MonkeyClicker/VMax-Smart-Gauge/releases/README.md

# Releases

Release notes, manifests, and supporting release metadata belong here.

Compiled OTA firmware binaries should normally be attached to GitHub Releases rather than committed repeatedly to the repository.
