MonkeyClicker/VMax-Smart-Gauge/hardware/datasheets/README.md

# Datasheets

Store links, notes, and redistributable component documentation here.

Primary components:
- [AliExpress male NMEA 2000 pigtail](AliExpress-NMEA2000-Panel-Male.md) — current panel candidate; seller cutout 15.5-16 mm
- [USB-C panel extension, FPC-10cm](USB-C-Panel-Extension.md) — ordered; mounting dimensions and bench verification pending
- [Hat Labs male NMEA 2000 panel pigtail connector](Hat-Labs-NMEA2000-Panel-Male.md) — selected enclosure connector; [CAD specification data](Hat-Labs-NMEA2000-Panel-Male.json)
- Waveshare ESP32-S3-Touch-LCD-5
- ESP32-S3-WROOM-1-N16R8
- TJA1051 CAN transceiver

Do not commit copyrighted vendor documents unless redistribution is permitted; links and engineering notes are preferred.

See the [bill of materials](../BOM.md) for component selections and procurement status.

Purchased component: [Yamaha engine-to-NMEA 2000 interface cable](Yamaha-Engine-Interface-Purchased.md) — Amazon ASIN B0BRM64RSX; user-confirmed purchase.
