MonkeyClicker/VMax-Smart-Gauge/hardware/schematics/README.md

# Schematics

Electrical schematics and protection/interface designs belong here.

The initial prototype uses the Waveshare onboard TJA1051 CAN transceiver. A later permanent-installation design may add galvanic isolation and marine transient protection.
