MonkeyClicker/VMax-Smart-Gauge/enclosure/CAD/README.md

# CAD

Editable enclosure CAD source files belong here.

The design should preserve access to internal USB recovery while keeping normal external penetrations sealed.

Current source: [vmax_dash.scad](vmax_dash.scad). See the [build guide](../README.md) before exporting.
