MonkeyClicker/VMax-Smart-Gauge/enclosure/drawings/README.md

# Drawings

Dimensioned drawings, mounting templates, gasket drawings, and assembly diagrams belong here.

Current files: [preview](preview.png), [1:1 dash template](dash-template.svg), and [mesh checks](mesh-checks.json). The template is provisional; verify the printed case before cutting.
