MonkeyClicker/VMax-Smart-Gauge/media/photos/README.md

# Photos

Add project photos here. Use descriptive filenames and document what each photo shows in the relevant wiring, hardware, or testing guide.
