MonkeyClicker/VMax-Smart-Gauge/nmea/sample-data/README.md

# Sample Data

Small sanitized NMEA 2000 datasets used for parser development and regression testing belong here.

Prefer datasets that cover:
- PGN 127488 engine rapid update
- PGN 127489 engine dynamic
- PGN 127505 fluid level
- PGN 129025 position
- PGN 129026 COG/SOG
- PGN 129029 GNSS
- unavailable-value cases
- stale/disconnected cases
