MonkeyClicker/VMax-Smart-Gauge/media/graphics/vmax-dash-mounted-concept-v1-prompt.txt

Generated using the built-in image generation tool.
Concept visualization; not a dimensional CAD rendering.

Use case: product-mockup. Create a photorealistic premium concept graphic of the V MAX Smart Gauge flush-mounted in a modern performance fishing boat dashboard. Input image is a reference for the actual screen layout and landscape 5-inch 800x480 display, not an image to reproduce as a workbench photograph. Show a tight three-quarter front product view, gauge dominant, with enough surrounding charcoal marine dash, partial steering wheel at lower left and softly blurred water beyond helm to establish installation. Custom cool bezel: satin graphite black sculpted rounded rectangular frame with crisp faceted chamfers, restrained layered shoulders, a narrow metallic electric-blue inlaid perimeter accent (not glowing LED), small tasteful machined corner details, concealed mounting. Screen opening 5:3 landscape, bezel approximately 197mm wide by 162mm tall so substantial upper/lower borders, only a few mm proud of dash, all housing concealed behind panel. Small engraved 'V MAX' centered in lower bezel. Realistic manufacturable industrial design, premium marine accessory, not sci-fi. Screen closely follows reference: navy background, cyan RPM arc on left reading 4465 ENGINE RPM, right six tiles GPS SPEED 42.0 mph, TRIM 38%, FUEL FLOW 14.3 gph, ENGINE TEMP 150 F, OIL PRESSURE 62 psi, COURSE 84 deg; bottom data and five navigation tabs ENGINE PERFORMANCE TRIP DIAGNOSTICS SETTINGS. Keep screen readable and properly in perspective. Soft natural daylight, subtle glass reflections, crisp realistic materials, shallow depth of field but entire bezel sharp. Landscape hero image. No infographic labels, no explanatory text, no watermark, no exposed wires, no bracket, no giant knobs.
