MonkeyClicker/VMax-Smart-Gauge/hardware/datasheets/QIANRENON-MicroSD-Panel-Extension.md

# QIANRENON waterproof panel-mount microSD extension — acquired

BOM ID: **SD-EXT-01**, quantity **1**. User confirmed the part was acquired
on 2026-10-26. Physical measurement and electrical testing are pending.

## Selected item

The user-provided product screenshot identifies:

- Brand: **QIANRENON**
- Model name shown by the listing: **21926**
- Product type: threaded front-panel/bulkhead microSD/TF extension
- External connector: capped female microSD/TF socket
- Internal connector: microSD/TF male plug on flexible FPC ribbon
- Ribbon length: **16 cm / 6.3 in**
- Required round panel opening: **21 mm diameter**
- Maximum panel thickness: **6.3 mm / 0.25 in**
- Mounting thread: **13/16-28 UNS**
- Nominal dimension shown in the listing image: **28 mm / 1.1 in**
- Seller/listing ingress claim: **IP67**, waterproof and dustproof
- Included hardware shown: mounting nut, O-ring and tethered cap

Source evidence is the user-supplied screenshot
`codex-clipboard-9cc424cd-e1bf-49b5-86e4-1af5bdf2e44b.png`. The screenshot
is not stored in this repository. A stable product URL and manufacturer drawing
have not been recorded.

## Intended use

The extender relocates the Waveshare board's onboard microSD/TF slot to the
rear panel. The flexible ribbon must route without a sharp crease, rubbing edge,
or tension on the board socket. Support the external receptacle with its bulkhead
nut and O-ring; do not use the internal card-shaped plug or ribbon as strain
relief.

This component creates the third rear-panel port, alongside NMEA 2000 and USB-C.
The existing 3 mm printed panel is within the listing's 6.3 mm maximum thickness,
but the current two-port panel and 64 × 26 mm rear-cover opening were not designed
for three connector flange/nut envelopes. Redesign the opening and replaceable
panel only after measuring all three received connectors.

## Receipt checks

Before final CAD or exposed boat use, measure and record:

- actual thread major diameter and required print clearance
- flange, cap, nut and O-ring outside diameters
- threaded grip length and usable panel-thickness range
- inward projection, ribbon exit direction and minimum comfortable bend radius
- clearance needed to insert/remove the card and unscrew the cap
- continuity and card read/write operation through the extender
- sealing contact and cap/O-ring fit

The IP67 statement is a product-listing claim, not an enclosure-system rating.
The completed panel, printed material, gasket, fasteners and installation still
require leak testing. Power down or have firmware unmount the card before removal.
