MonkeyClicker/VMax-Smart-Gauge/hardware/datasheets/AliExpress-NMEA2000-Panel-Male.md

# AliExpress male NMEA 2000 pigtail — current panel design candidate

Reference: https://www.aliexpress.us/item/3256809787663943.html
User screenshot shows FireEarth branding and selected Male option. The user
supplied the following seller specifications on 2026-10-20; not yet measured:

| Property | Seller specification |
| --- | --- |
| Interface | M12 A-coded, 5-pin; listing offers male/female, user selected male |
| Mount | Bulkhead threaded chassis, front panel mount |
| Lead length | 0.3 m |
| Conductors | 22 AWG |
| OD | 2.4 mm; listing does not identify exactly what this measures |
| Protection | IP67 seller claim; conditions unconfirmed |
| Panel cutout | **15.5-16 mm** |

Use **16 mm** nominal cutout for the first panel fit-test. No additional
printer allowance is included. This supersedes the Hat Labs 12 mm cutout for
the current panel candidate. M12 describes the mating interface and does not
establish the bulkhead mounting-hole size.

Procurement: under evaluation; order confirmation for this NMEA item has not
been explicitly received. Hat Labs remains an alternate, with purchase deferred
because of shipping/tariff cost. Do not treat Hat Labs dimensions, wire colors
or gauges as specifications of this item.

Still needed: mounting thread and usable length, maximum panel thickness,
flange and nut envelope, body projections, seal hardware, antirotation flats,
and pin-to-lead continuity. Verify these on delivery before sealed assembly.
Keep the unused network-power conductor insulated for the USB-powered prototype;
identify it by confirmed pin mapping, not assumed colors.
