MonkeyClicker/VMax-Smart-Gauge/nmea/captures/scanner-usb-20261009T213839Z.md

# Scanner capture — October 9, 2026

File: [scanner-usb-20261009T213839Z.log](scanner-usb-20261009T213839Z.log)

- Capture started at 21:38:39 UTC (5:38:39 PM America/New_York).
- Duration: approximately 30 seconds, USB COM6 at 115200 baud.
- Original received serial bytes preserved; file size 5550 bytes.
- Firmware: blue-screen receive-only NMEA scanner; 250 kbit/s.
- User initially reported Garmin GPS powered. This capture also contains engine
  PGNs from source 2; exact ignition/network power state was not confirmed.

## Observations

- GPS source 0: decoded speed 0.000 m/s and course 0.000 rad.
- Engine source 2, instance 1: decoded RPM 0.000 and trim 2%.
- GPS/navigation PGNs observed include 129025, 129026, 129029, and 129540.
- Engine PGNs observed include 127488 and 127489.
- CAN driver remained running. Missed-frame counter stayed at 20; hardware
  receive overruns stayed at 0.
- Cumulative bus-error counter increased from 16018 to 23685 between the first
  and last reports (approximately 25 seconds). Connection is not yet validated
  as healthy.
- Screen refresh count increased; free heap remained 106048 bytes and free
  PSRAM remained 6894332 bytes.
- Uptime and counters are lower than the preceding live read, indicating a
  restart or reinitialization between reads; cause was not established.

## Capture limitations

This file contains five-second diagnostic snapshots, not raw CAN frames or a
lossless NMEA message capture. Some received serial lines are visibly truncated
or merged. Preserve the original file and treat damaged rows as incomplete;
missing text has not been reconstructed. PGN rates count CAN frames, including
fast-packet fragments, rather than reassembled messages. No latitude/longitude
coordinates are decoded in this output. Garmin/Yamaha source identities have
not been verified through device identification messages.
