MonkeyClicker/VMax-Smart-Gauge/enclosure/drawings/screwless-concept-v2/sheet-5.png

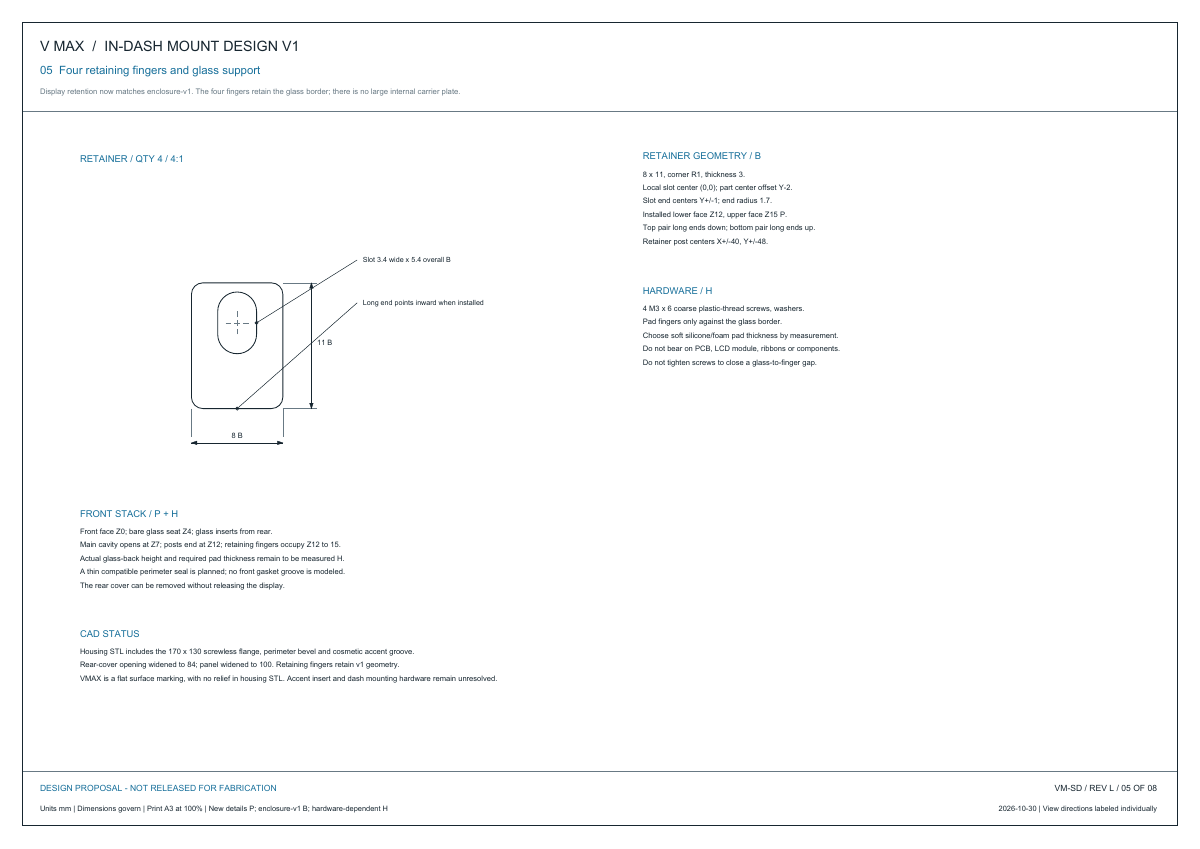
enclosure/drawings/screwless-concept-v2/sheet-5.png
