MonkeyClicker/VMax-Smart-Gauge/hardware/photos/20260821_164633.jpg

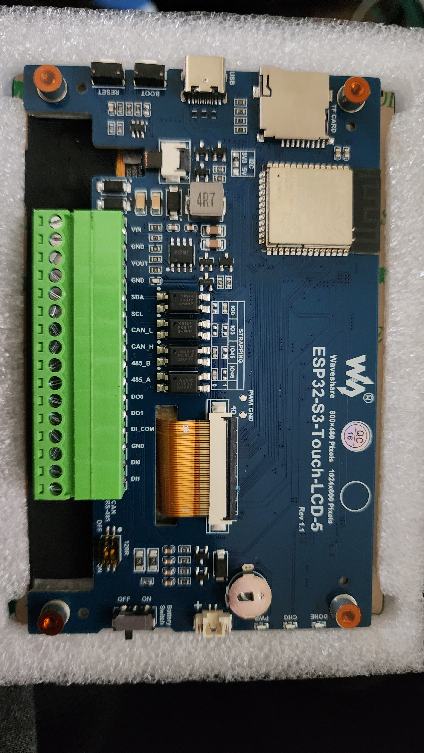
hardware/photos/20260821_164633.jpg
