MonkeyClicker/VMax-Smart-Gauge/hardware/photos/20260821_164657.jpg

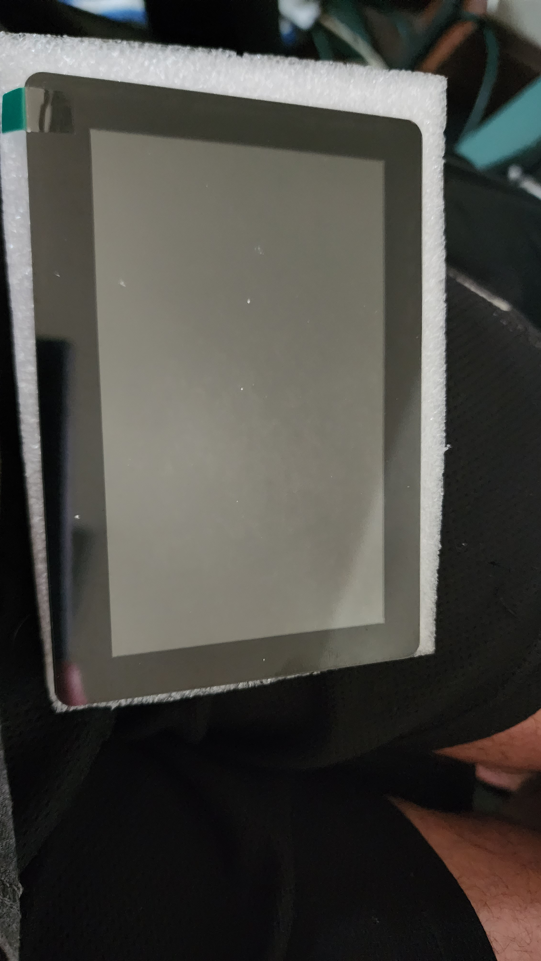
hardware/photos/20260821_164657.jpg
