MonkeyClicker/VMax-Smart-Gauge/media/graphics/vmax-dash-mounted-concept-v2.png

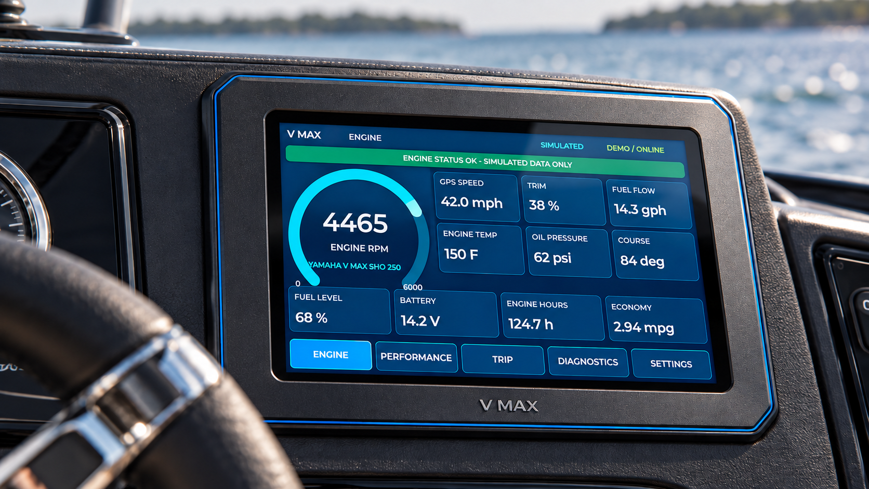
media/graphics/vmax-dash-mounted-concept-v2.png
