MonkeyClicker/VMax-Smart-Gauge/media/graphics/vmax-smart-gauge-infographic-v1.png

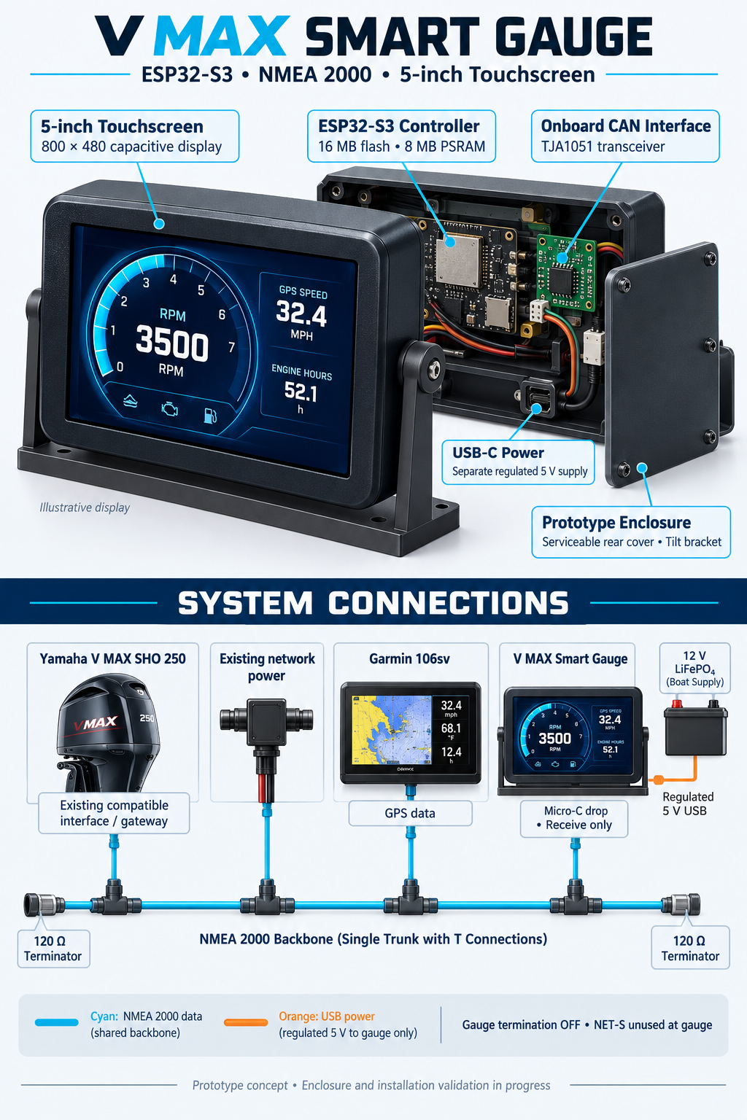
media/graphics/vmax-smart-gauge-infographic-v1.png
