MonkeyClicker/VMax-Smart-Gauge/ui/screenshots/2026-10-21-simulator-diagnostics.jpg

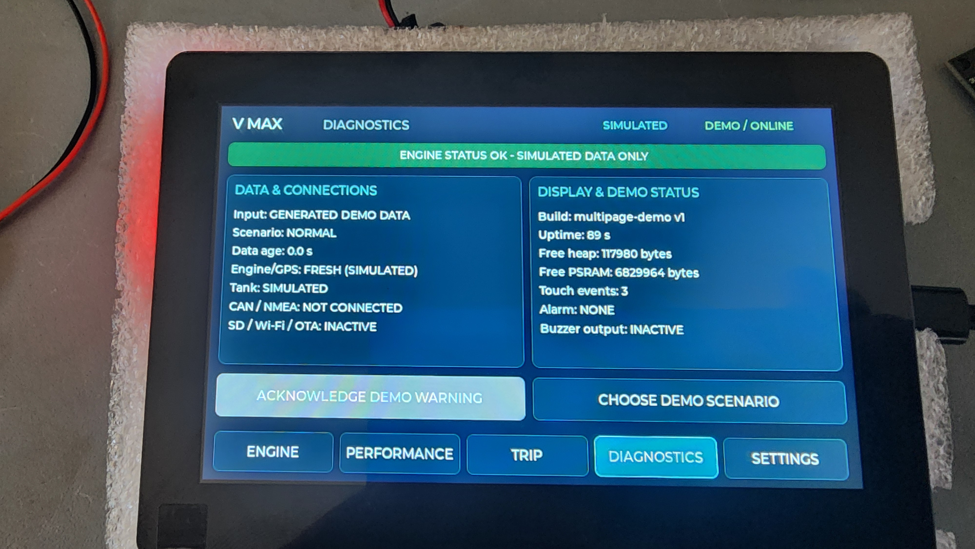
ui/screenshots/2026-10-21-simulator-diagnostics.jpg
