MonkeyClicker/VMax-Smart-Gauge/ui/screenshots/2026-10-21-simulator-engine.jpg

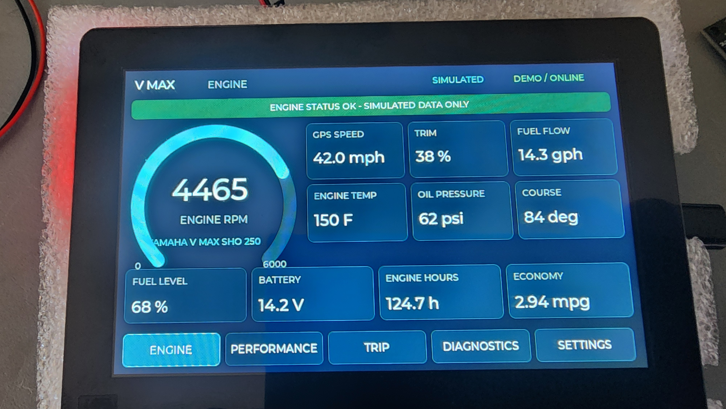
ui/screenshots/2026-10-21-simulator-engine.jpg
