MonkeyClicker/VMax-Smart-Gauge/hardware/datasheets/Yamaha-Engine-Interface-Purchased.md

# Purchased Yamaha engine-to-NMEA 2000 interface cable

User confirmed this exact purchased item on October 21, 2026.

- Purchase listing: https://www.amazon.com/dp/B0BRM64RSX
- Amazon ASIN: **B0BRM64RSX**
- Listing describes a replacement for **000-0120-37 / 3004.6865**, with a
  T-connector and nominal **4.5 m / 15 ft** cable.
- Intended role: Yamaha engine data connection to the NMEA 2000 backbone.

The listing markets an aftermarket replacement; do not record the purchased
unit as genuine Lowrance equipment without separate evidence. Purchase is
confirmed by the user; installation, exact motor/harness compatibility, and
successful operation of this specific cable are not established by this note.

Related: [Complete boat wiring guide](../../docs/Complete-Wiring.md).

## Product picture and purchase link

Seller product photo: Yamaha engine interface cable and T-connector (https://www.amazon.com/dp/B0BRM64RSX)

[Open the exact purchased Amazon listing](https://www.amazon.com/dp/B0BRM64RSX).
Image is remotely linked from the seller listing; copyright remains with its owner.

## Seller-listed specifications

| Item | Listing information |
| --- | --- |
| Brand | usvehj |
| Replacement references | 000-0120-37; 3004.6865 |
| Cable length | 4.5 m / 15 ft |
| Engine connector | 4-pin data connector |
| Network | NMEA 2000 |
| Supplied items | Interface sensor, cable, network T-connector |
| Intended connection | Engine data socket under cowling to NMEA 2000 network |
| Installation described | Engines without Command Link / Command Link Plus |

Seller claims support for selected Yamaha models from 2006 onward; this is not
independent confirmation for the project's exact 2024 VF250 SHO installation.
Specifications above describe the purchased aftermarket listing, not a genuine
Lowrance unit.

## Cost

- Actual amount paid: **US $27.99**, confirmed by the user on October 21, 2026.
- Current Amazon price: not available in the retrieved listing on October 21,
  2026; the page reports no featured offer. Check the purchase link for offers.
- The previously quoted $126 was for the separate genuine Lowrance product,
  not the cost of this purchased aftermarket cable.
