MonkeyClicker/VMax-Smart-Gauge/enclosure/STL/body.stl

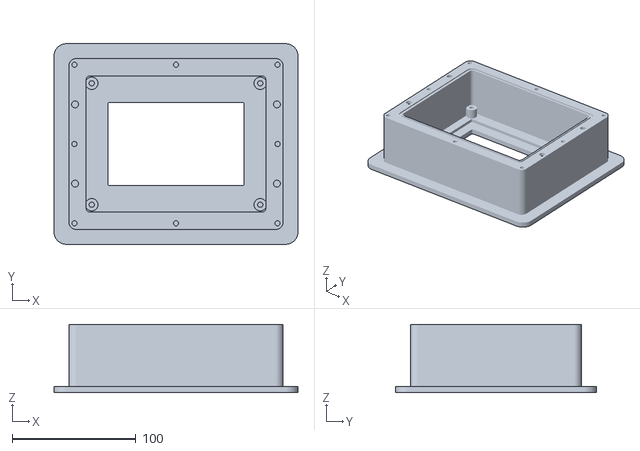
[picture p13: CAD file, 2026-10-21]
enclosure/STL/body.stl
197.0 x 162.0 x 55.0
