MonkeyClicker/VMax-Smart-Gauge/enclosure/STL/external-v1/tilt-bracket.stl

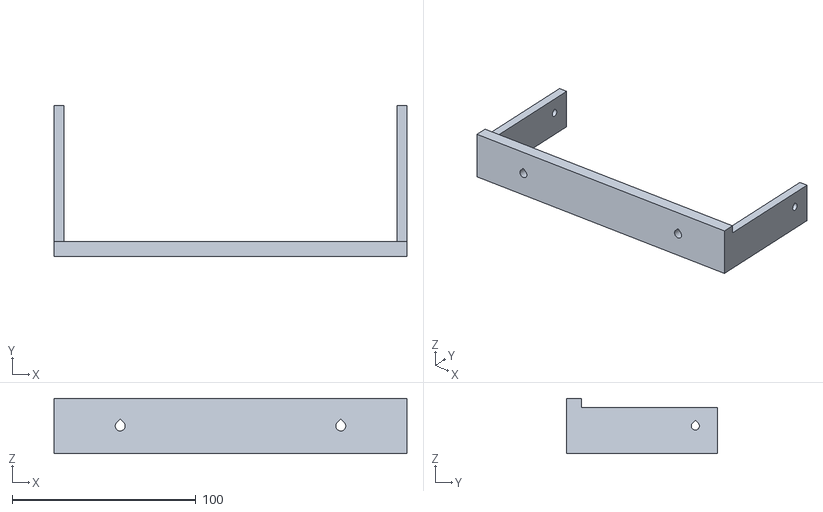
[picture p14: CAD file, 2026-10-29]
enclosure/STL/external-v1/tilt-bracket.stl
192.0 x 82.0 x 30.0
