MonkeyClicker/VMax-Smart-Gauge/enclosure/STL/clamp.stl

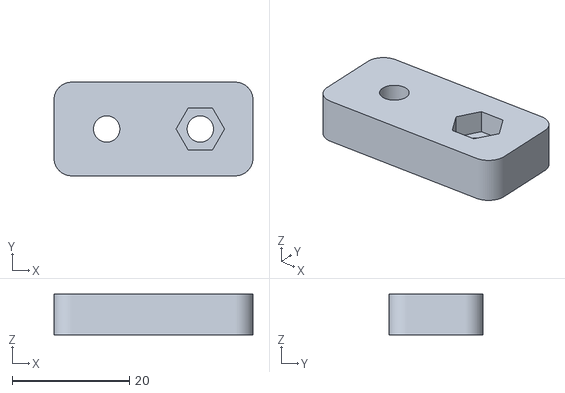
[picture p15: CAD file, 2026-10-21]
enclosure/STL/clamp.stl
34.0 x 16.0 x 7.00
