MonkeyClicker/VMax-Smart-Gauge/enclosure/STL/external-v1/rear-cover.stl

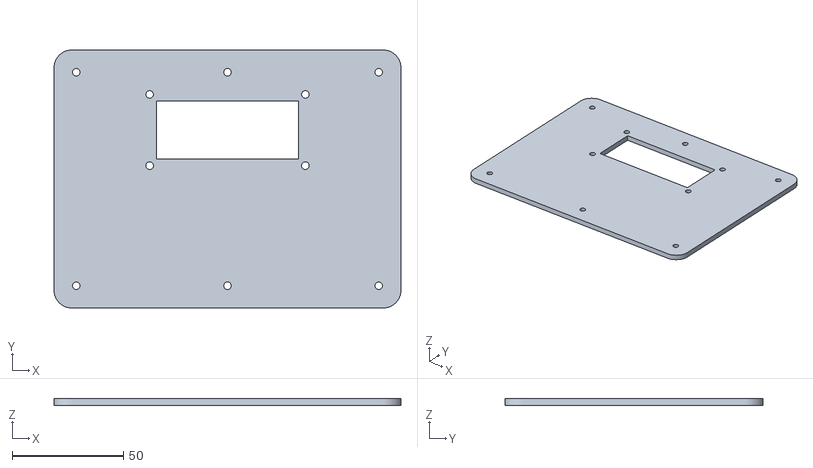
[picture p16: CAD file, 2026-10-21]
enclosure/STL/external-v1/rear-cover.stl
156.0 x 116.0 x 3.00
