MonkeyClicker/VMax-Smart-Gauge/enclosure/STL/fit_test.stl

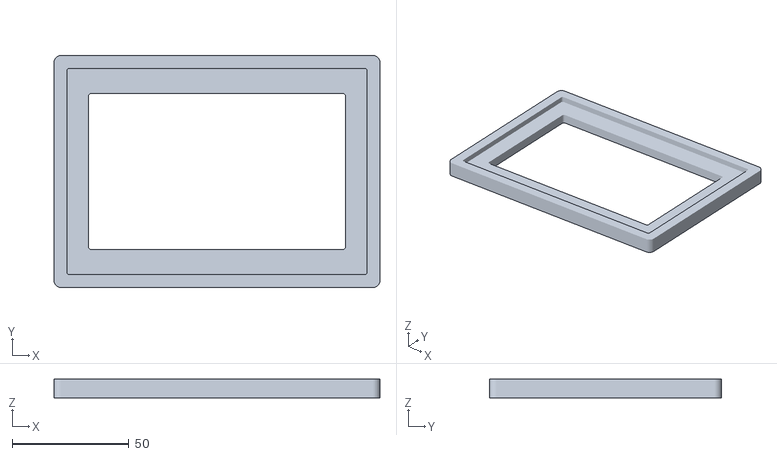
[picture p17: CAD file, 2026-10-21]
enclosure/STL/fit_test.stl
139.7 x 99.4 x 8.00
