MonkeyClicker/VMax-Smart-Gauge/enclosure/STL/screwless-v2/rear-housing-glue-option.stl

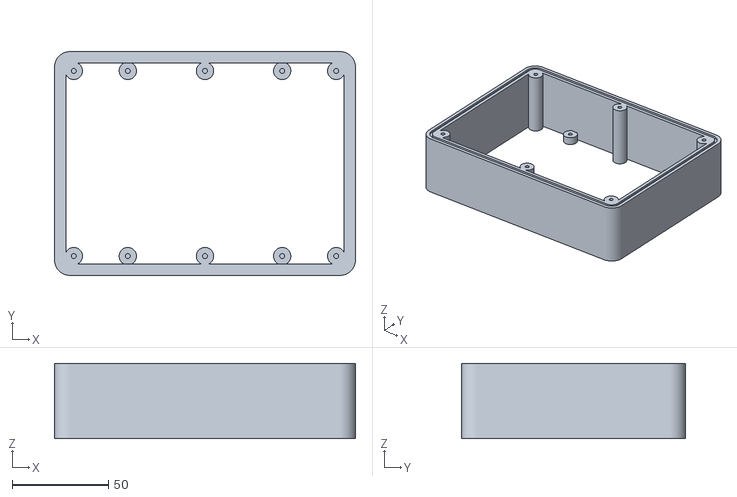
[picture p18: CAD file, 2026-11-03]
enclosure/STL/screwless-v2/rear-housing-glue-option.stl
156.0 x 116.0 x 39.0
