MonkeyClicker/VMax-Smart-Gauge/enclosure/STL/screwless-v2/rear-cover-one-piece-three-port.stl

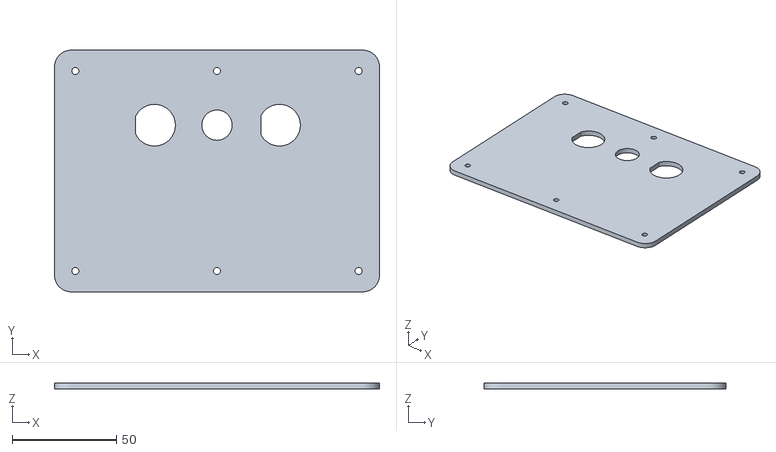
[picture p19: CAD file, 2026-11-03]
enclosure/STL/screwless-v2/rear-cover-one-piece-three-port.stl
156.0 x 116.0 x 3.00
