MonkeyClicker/VMax-Smart-Gauge/enclosure/STL/screwless-v2/display-retainer-print-4.stl

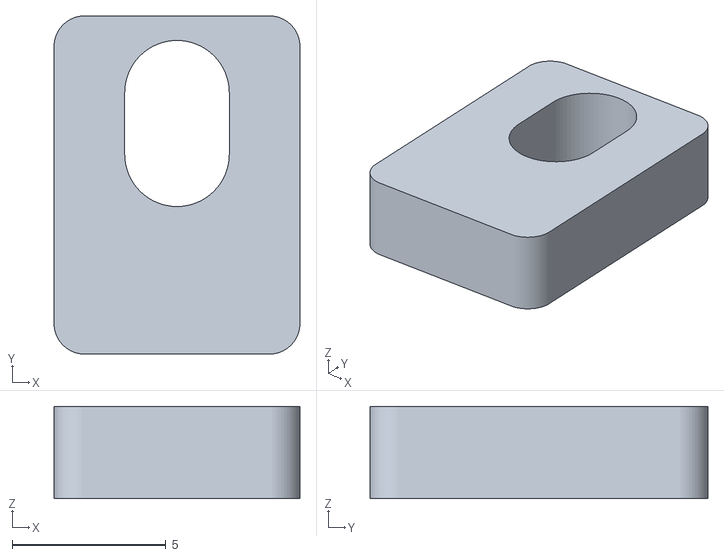
[picture p20: CAD file, 2026-11-03]
enclosure/STL/screwless-v2/display-retainer-print-4.stl
7.99 x 11.0 x 3.00
