MonkeyClicker/VMax-Smart-Gauge/enclosure/CAD/external-v1/display-retainer-print-4.scad

// VMax external draft 1; mm; generated by external-enclosure-v1.py
difference(){translate([0,-2,0]){linear_extrude(height=3)polygon(points=[[4.0, 4.5], [3.995184726672197, 4.598017140329561], [3.9807852804032304, 4.695090322016128], [3.9569403357322086, 4.790284677254462], [3.923879532511287, 4.88268343236509], [3.881921264348355, 4.971396736825998], [3.8314696123025453, 5.055570233019602], [3.773010453362737, 5.134393284163646], [3.7071067811865475, 5.207106781186548], [3.6343932841636457, 5.273010453362737], [3.555570233019602, 5.331469612302545], [3.4713967368259975, 5.381921264348355], [3.3826834323650896, 5.423879532511287], [3.2902846772544625, 5.456940335732209], [3.1950903220161284, 5.48078528040323], [3.0980171403295604, 5.495184726672197], [3.0, 5.5], [-3.0, 5.5], [-3.0980171403295604, 5.495184726672197], [-3.195090322016128, 5.48078528040323], [-3.2902846772544625, 5.456940335732209], [-3.3826834323650896, 5.423879532511287], [-3.471396736825998, 5.381921264348355], [-3.555570233019602, 5.331469612302545], [-3.6343932841636453, 5.273010453362737], [-3.7071067811865475, 5.207106781186548], [-3.773010453362737, 5.134393284163646], [-3.8314696123025453, 5.055570233019602], [-3.881921264348355, 4.971396736825998], [-3.923879532511287, 4.88268343236509], [-3.9569403357322086, 4.790284677254462], [-3.9807852804032304, 4.695090322016128], [-3.9951847266721967, 4.598017140329561], [-4.0, 4.5], [-4.0, -4.5], [-3.995184726672197, -4.598017140329561], [-3.9807852804032304, -4.695090322016128], [-3.956940335732209, -4.790284677254462], [-3.923879532511287, -4.88268343236509], [-3.881921264348355, -4.971396736825998], [-3.8314696123025453, -5.055570233019602], [-3.773010453362737, -5.134393284163645], [-3.707106781186548, -5.207106781186548], [-3.6343932841636457, -5.273010453362737], [-3.555570233019602, -5.331469612302545], [-3.471396736825998, -5.381921264348355], [-3.3826834323650896, -5.423879532511287], [-3.2902846772544625, -5.456940335732209], [-3.195090322016129, -5.48078528040323], [-3.0980171403295604, -5.495184726672197], [-3.0, -5.5], [3.0, -5.5], [3.09801714032956, -5.495184726672197], [3.1950903220161284, -5.48078528040323], [3.290284677254462, -5.456940335732209], [3.38268343236509, -5.423879532511287], [3.4713967368259975, -5.381921264348355], [3.5555702330196017, -5.331469612302546], [3.6343932841636457, -5.273010453362737], [3.7071067811865475, -5.207106781186548], [3.7730104533627373, -5.134393284163645], [3.8314696123025453, -5.055570233019602], [3.881921264348355, -4.971396736825998], [3.923879532511287, -4.88268343236509], [3.9569403357322086, -4.790284677254462], [3.9807852804032304, -4.695090322016129], [3.995184726672197, -4.598017140329561], [4.0, -4.5]]);}union(){union(){translate([0,-1,-1]){cylinder(h=5,r=1.7,$fn=64);}translate([0,1,-1]){cylinder(h=5,r=1.7,$fn=64);}}translate([0,0,-1]){translate([-1.7,-1.0,0])cube([3.4,2,5]);}}}
