MonkeyClicker/VMax-Smart-Gauge/(list of files, cad)

Other CAD files:
enclosure/CAD/external-v1/rear-cover.scad
enclosure/CAD/screwless-v2/rear-housing-glue-option.scad
