MonkeyClicker/VMax-Smart-Gauge/hardware/wiring/README.md

# Wiring

Wiring diagrams, connector pinouts, and installation notes belong here.

Planned content:
- NMEA 2000 Micro-C to CAN wiring
- Waveshare CAN terminal wiring
- LiFePO4 USB power arrangement
- prototype wiring diagram
- permanent-installation wiring diagram
