MonkeyClicker/VMax-Smart-Gauge/ui/mockups/scanner-blue-performance-approved.png

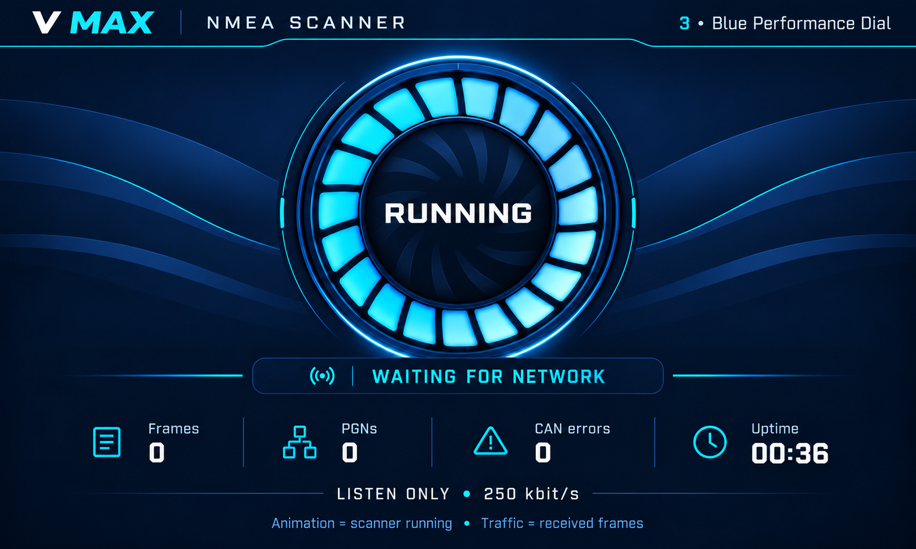
ui/mockups/scanner-blue-performance-approved.png
