MonkeyClicker/VMax-Smart-Gauge/firmware/include/esp_panel_board_supported_conf.h

#pragma once

#define ESP_PANEL_BOARD_DEFAULT_USE_SUPPORTED (1)

#if ESP_PANEL_BOARD_DEFAULT_USE_SUPPORTED
#define BOARD_WAVESHARE_ESP32_S3_TOUCH_LCD_5
#define ESP_PANEL_BOARD_SUPPORTED_FILE_VERSION_MAJOR 1
#define ESP_PANEL_BOARD_SUPPORTED_FILE_VERSION_MINOR 0
#define ESP_PANEL_BOARD_SUPPORTED_FILE_VERSION_PATCH 0
#endif
