MonkeyClicker/VMax-Smart-Gauge/(commit log)

2026-08-18 Add hardware and wiring documentation
2026-08-18 Add enclosure design documentation
2026-08-18 Create hardware wiring directory
2026-08-18 Create hardware schematics directory
2026-08-18 Create NMEA sample data directory
2026-08-18 Create enclosure CAD directory
2026-08-18 Create enclosure STL directory
2026-08-18 Create enclosure drawings directory
2026-08-18 Add power design notes
2026-08-18 Add prototype wiring design documentation
2026-08-18 Use supported Arduino 3 display toolchain
2026-08-18 Fix LVGL adapter Arduino helper include
    [LvglPort.cpp]
2026-08-20 docs: add buzzer output wiring guidance
2026-10-03 Fix scanner decoding, data validity, and diagnostics
    [BoatData.h, Scanner.h, main.cpp]
2026-10-05 Fix simulated gauge bring-up and document verified Waveshare setup
    [main.cpp]
2026-10-08 docs: add complete VMAX boat wiring guide with part numbers
2026-10-10 Document board wiring photos and first boat scanner capture
2026-10-10 Improve scanner capture integrity and CAN error diagnostics
    [ScannerDiagnostics.h, main.cpp]
2026-10-10 Fix scanner command latency, reconnect metadata, and record sequence integrity
    [ScannerLogging.h, main.cpp]
2026-10-14 Add printable PETG flush-dash enclosure prototype
2026-10-20 Add bezel fit tests and external enclosure prototype draft
2026-10-20 Add connector BOM and two-port enclosure cable panel
2026-10-21 Remove infographic drafts and document purchased Yamaha interface cable
2026-10-23 Redesign tilt bracket for side printing
2026-10-25 docs: add VMAX cover vector prototype
2026-10-25 cad: add matched VMAX cover and in-dash mount source
2026-10-26 docs: add acquired microSD panel extension to BOM
2026-10-26 docs: require three rear enclosure ports
2026-10-30 Add version 1 in-dash mount design checkpoint
2026-10-30 Add STL-only download for in-dash mount design v1
2026-11-03 Flatten bezel lettering and add glue-together housing option
